themonsteredu/keyring/README.md

# 키링 스튜디오 · 우유팩 감정·날씨 키링

ESP32-C3 SuperMini와 128×64 OLED로 만드는 **우유팩 표정 키링**입니다. **2.2.0**은 도톰한 눈·입으로 여섯 감정을 보여 주고, 날씨는 웃는 아이콘·온도·습도로 표시합니다. 웹에서 표정을 고르거나 블록으로 움직이는 순서를 만들어 실제 키링에 저장할 수 있습니다.

[온라인 키링 스튜디오 열기](https://keyring-swart.vercel.app) · [Arduino IDE용 ZIP 내려받기](https://raw.githubusercontent.com/themonsteredu/keyring/main/downloads/Keyring-Arduino.zip)

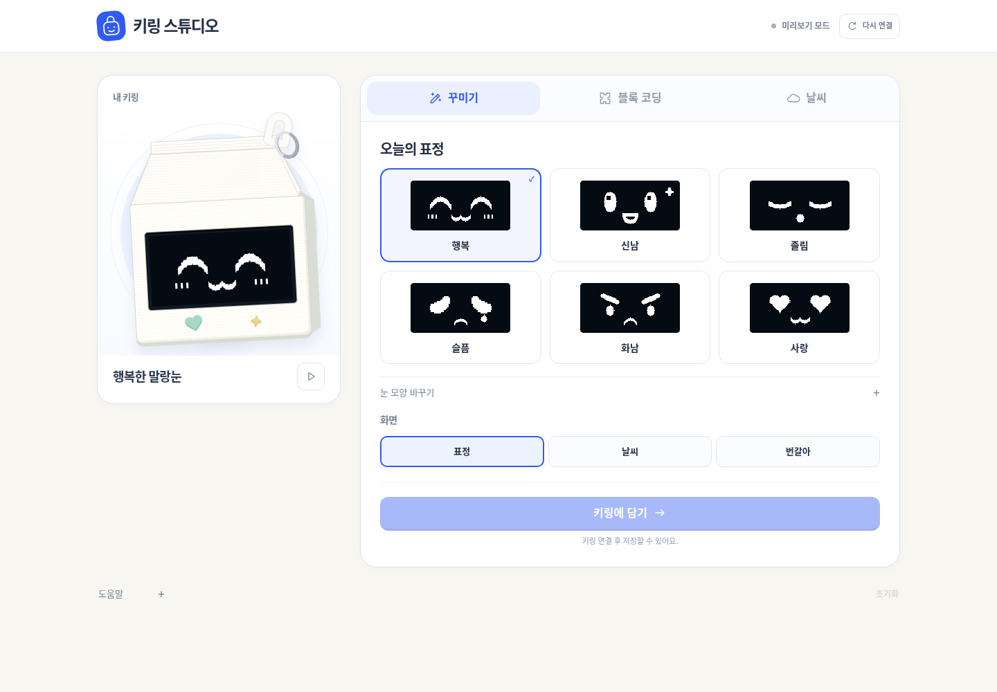
[picture p1: docs/images/studio-desktop.png]
키링 스튜디오 화면


[모바일 화면 보기](docs/images/studio-mobile.png) · [블록코딩 사용법](docs/block-coding.md)

## 우유팩 케이스 3D 출력

[우유팩 STL 묶음 다운로드](https://raw.githubusercontent.com/themonsteredu/keyring/main/downloads/Milk-Carton-Keyring-STL.zip) · [출력·조립 안내](cad/milk-carton/README.md)

본체·뒷뚜껑·OLED 시험판 STL과 편집용 STEP을 제공합니다. 조립 크기는 약 **42 × 75 × 34.4mm**입니다. 일반적인 모듈 치수를 기준으로 한 시제품이므로 OLED 시험판을 먼저 출력하세요. 케이스 고정용 **플라스틱용 2×8mm 나사 4개와 절연 폼테이프**가 별도로 필요합니다.

## 준비물과 고정 배선

현재 필요한 부품은 ESP32-C3 SuperMini, 0.96인치 I2C SSD1306 OLED, 암암 점퍼선 4개, 데이터 전송이 되는 USB-C 케이블입니다. 전원은 USB를 사용합니다. 배터리·충전 회로·추가 버튼은 가정하지 않습니다.

| OLED | ESP32-C3 SuperMini |
| --- | --- |
| GND | G |
| VCC | 3.3V |
| SDA | GPIO4 |
| SCL | GPIO5 |

**SDA는 GPIO4, SCL은 GPIO5로 고정합니다.** 이 배선은 기존 `OLED OK` 테스트에서 동작한 배선입니다. USB 전원을 분리한 상태에서 연결하고, OLED VCC를 5V에 연결하지 않습니다.

## 처음 사용하기

1. [Arduino IDE용 ZIP](downloads/Keyring-Arduino.zip)을 내려받아 `Keyring/Keyring.ino`를 엽니다. 전체 저장소를 받았다면 `firmware/Keyring/Keyring.ino`를 사용합니다. [배선·업로드 안내](docs/hardware-and-upload.md)에 따라 라이브러리를 준비하고 업로드합니다.
2. 시리얼 모니터에서 기기의 Wi-Fi 이름을 확인합니다. 기기별 이름은 `Keyring-XXXXXX`입니다.
3. 스마트폰에서 해당 Wi-Fi에 접속합니다. 기본 수업용 암호는 `keyring123`입니다.
4. 인터넷에 연결되지 않았다는 안내가 나오면 이 Wi-Fi 연결을 유지합니다. 브라우저 주소창에 `http://192.168.4.1`을 입력합니다.
5. **꾸미기** 탭에서 표정을 고르고 **키링에 담기**를 누릅니다. 다른 눈 모양은 **눈 모양 바꾸기**를 펼쳐 고릅니다. 저장 성공 안내와 실제 OLED를 모두 확인합니다.
6. **블록 코딩**에서 순서·기다리기·반복 블록을 연결하고 **실행**을 누릅니다. **키링에 담기** 후 실제 OLED에서도 확인합니다.
7. 날씨는 아래의 **인터넷 없이 날씨 가져오기** 절차를 사용합니다.

Arduino IDE는 **ESP32C3 Dev Module**, ESP32 코어 **3.3.7**, Flash **4MB**, **USB CDC On Boot: Enabled**, **Partition Scheme: Huge APP (3MB No OTA/1MB SPIFFS)**로 설정합니다. 확인된 GPIO4/5 배선은 바꾸지 않습니다.

키링 Wi-Fi는 설정용 AP이며 인터넷 공유기가 아닙니다. 표정 설정과 저장에는 인터넷이 필요 없습니다. 기본 암호는 수업 편의를 위한 공용 암호이므로 개인 정보나 민감한 자료를 입력하지 말고, 사용을 마치면 전원을 분리합니다.

## 표정과 화면

첫 화면에는 미리보기와 여섯 표정, 담기 버튼이 보입니다. 눈 모양 선택은 **눈 모양 바꾸기**, 연결 안내는 하단 **도움말**을 펼쳐 확인합니다.

- 눈 모양: 말랑눈, 초롱눈, 웃음눈, 콩알눈, 네모눈
- 감정: 행복, 신남, 졸림, 슬픔, 화남, 사랑
- 애니메이션: 도톰한 눈의 깜빡임, 작은 입의 변화, 하트·눈물·졸음 표현
- 화면 모드: 표정, 날씨, 번갈아(자동 전환)

OLED에는 동물의 몸이나 얼굴 테두리를 그리지 않습니다. 케이스 자체가 캐릭터의 몸이 되고 화면은 표정을 보여 줍니다. 웹 미리보기도 우유팩 모양이며, 실제 케이스의 제작 치수나 조립 파일을 대신하지 않습니다.

픽셀 렌더러가 만든 128×64 흑백 프레임을 OLED와 웹 미리보기가 함께 사용합니다. 미리보기는 확대되어 보이지만 픽셀 비율은 같습니다. 화면은 일정 간격으로 갱신하고, 변경된 프레임만 전송합니다. OLED를 지우는 빈 화면을 중간에 따로 전송하지 않습니다.

## 실제로 실행하는 블록코딩

블록코딩은 Google Blockly를 사용하는 시각적 편집기입니다. 눈 모양 선택, 감정 선택, 기다리기, 날씨 보여주기, 반복, 날씨 조건 블록을 연결하면 프로그램이 됩니다. 편집기와 한국어 메시지는 웹 자산에 포함되어 키링 AP에서도 외부 CDN 없이 열립니다.

1. **키링 시작할 때 → 말랑눈 → 행복 → 1초 기다리기 → 사랑 → 1초 기다리기** 순서로 연결합니다.
2. **실행**으로 순서대로 표정이 바뀌는지 확인합니다. **반복**을 켜면 처음부터 계속 실행합니다.
3. 키링 AP에 연결된 화면에서 **키링에 담기**을 누릅니다. 실행이 켜진 프로그램은 전원을 다시 연결하면 기기에서 처음부터 실행합니다.
4. 직접 눈 모양과 표정을 고르고 적용하면 실행 중인 프로그램이 멈춥니다. 프로그램을 다시 실행하려면 블록 코딩 화면에서 **키링에 담기**을 누릅니다.

온라인 Vercel 화면은 실제 기기와 직접 연결되지 않습니다. 온라인에서 만든 프로그램을 **파일 저장 → 키링 Wi-Fi로 전환 → 불러오기 → 키링에 담기** 순서로 옮깁니다. 브라우저 미리 실행과 기기에 저장한 실행은 구분합니다. 단계별 설명과 예제는 [블록코딩 안내](docs/block-coding.md)에 있습니다.

**도톰한 표정과 온도·습도 화면을 실제 OLED에 표시하려면 2.2.0 펌웨어를 다시 업로드해야 합니다.** 위 ZIP을 받거나 `firmware/Keyring/Keyring.ino`를 다시 빌드·업로드합니다. Vercel 화면만 새로 열어도 보드의 그림은 바뀌지 않습니다. 프로그램 API가 없는 예전 펌웨어 역시 업로드가 필요합니다. GPIO4/5 배선은 유지합니다.

## 인터넷 없이 날씨 가져오기

키링 자체가 인터넷에 접속하지 않아도 다음 순서로 실제 예보를 옮길 수 있습니다.

1. 인터넷이 되는 상태에서 이 프로젝트의 웹 화면을 엽니다. [온라인 키링 스튜디오](https://keyring-swart.vercel.app) 또는 교사가 준비한 PC 개발 서버를 사용할 수 있습니다.
2. **날씨** 탭에서 지역을 고르고 **날씨 받기**를 누릅니다. **파일 · 연습 → 파일 저장**에서 JSON을 내려받습니다.
3. 스마트폰을 키링 Wi-Fi로 바꿔 연결합니다.
4. `http://192.168.4.1`의 **날씨 → 파일 · 연습 → 불러오기**에서 JSON을 고릅니다. 연결된 키링에 저장됩니다.
5. 저장 성공을 확인합니다. **받은 시각 · 출처**에서 파일 정보를 볼 수 있습니다. 꾸미기의 화면을 **날씨** 또는 **번갈아**로 고르고 **키링에 담기**를 누릅니다.

휴대전화가 Wi-Fi와 이동통신을 동시에 사용할 수 있으면 기기 화면에서 직접 날씨를 받을 수도 있습니다. 휴대전화별 동작이 다르므로 수업에서는 파일 가져오기 방식을 준비하세요. 자세한 설명은 [날씨와 시간 처리](docs/weather.md)에 있습니다.

날씨 기본 화면에는 **큰 아이콘·반올림한 온도·상대습도**가 나타납니다. 습도는 선택한 지역의 Open-Meteo 예보 값이며 별도 실내 센서를 사용하지 않습니다. 예전 파일에 습도가 없으면 `--%`로 표시합니다. 웹의 **24시간 예보**, **받은 시각 · 출처**는 펼쳐서 확인합니다. OLED에서도 한 번에 한 시간의 예보를 보여 줍니다.

연습용·오래된 예보·시각 미확인은 작은 한글 표시로 구분합니다. **전원을 완전히 껐다 켜면 시계는 미확인 상태가 됩니다.** 스마트폰 설정 화면을 다시 열면 시간을 맞춥니다. 받은 지 3시간이 지났거나 예보 범위를 벗어난 파일은 새로 받아 주세요.

Open-Meteo의 무료 API는 비상업적 사용 조건이 적용됩니다. 유료 수업·판매 제품 등 상업적 사용 여부는 배포 전에 [공식 이용약관](https://open-meteo.com/en/terms)을 확인하고 적절한 이용 방식을 선택해야 합니다. 기상 데이터 출처는 Open-Meteo, 라이선스는 [CC BY 4.0](https://open-meteo.com/en/licence)입니다. 안전 판단이나 재난 경보용으로 사용하지 않습니다.

## 개발·빌드·테스트

클라우드 설치 스크립트는 Linux x86_64용입니다. 기본 도구로 Python 3.12 이상, Node.js 22 이상, C++ 컴파일러가 필요합니다. `tools/setup.sh`는 Arduino CLI **1.3.1**, ESP32 Arduino Core **3.3.7**, 고정 버전 라이브러리를 저장소 상위의 `.tooling`(이 환경에서는 `/workspace/.tooling`)에 준비하고 공식 배포 체크섬을 검증합니다. 웹 테스트 의존성은 `npm ci`로 설치합니다. Windows·macOS에서는 [Arduino IDE 안내](docs/hardware-and-upload.md)를 사용합니다.

```sh
cd /workspace/keyring
bash tools/setup.sh
bash tools/test.sh
bash tools/build.sh
npm run test:e2e
```

웹 개발 서버는 다음과 같이 실행합니다.

```sh
python3 tools/dev_server.py --port 8000
```

기본 개발 서버는 기기 API가 없는 독립 웹 화면으로 실행됩니다. 개발·브라우저 테스트용 모의 기기는 `--mock` 옵션으로 켜며, 모의 응답은 실물 ESP32 검증을 대신하지 않습니다. 스마트폰에서 PC 개발 서버에 접속하려면 PC와 스마트폰이 같은 네트워크에 있어야 하며, PC의 네트워크 주소를 사용해야 합니다. 기본 서버는 PC 내부 접속용이므로 스마트폰에도 열려면 `--host 0.0.0.0` 옵션을 추가합니다. 키링 AP 주소는 실제 펌웨어를 업로드한 기기에 접속했을 때만 사용할 수 있습니다.

웹 파일을 수정한 후에는 펌웨어용 웹 자산을 다시 생성하고 빌드해야 합니다. 웹 자산은 펌웨어에 포함되므로 별도의 SPIFFS/LittleFS 파일 업로드는 필요하지 않습니다. 세부 명령과 테스트 범위는 [개발 구조·API](docs/development.md)를 참고하세요.

## 폴더 구성

```text
firmware/Keyring/   Arduino 스케치, 픽셀 렌더러, 저장·시간 규칙, 내장 웹 자산
web/               꾸미기·Blockly·날씨 UI, 공통 픽셀 프레임, 로컬 편집기 자산
tools/             설치·빌드·자산 생성·개발 서버
tests/             C++ 및 JavaScript 테스트
docs/              배선, 업로드, 학생·교사 안내, 날씨와 API 설명
```

## 검증 범위

이 저장소의 자동 테스트는 픽셀 데이터, 설정·시간·날씨 규칙, 프로그램 검증·실행과 웹 동작을 대상으로 하며, ESP32-C3 타깃 빌드는 업로드 가능한 펌웨어의 컴파일을 검증합니다. **클라우드에서 실물 보드에 업로드하거나 물리 OLED를 관찰한 것은 아닙니다.** 사용자가 앞서 확인한 `OLED OK`는 기존 하드웨어·배선 테스트 결과이며 이번 통합 펌웨어의 실물 검증 결과와 구분합니다.

수업 전에 [교사용 확인표](docs/teacher-guide.md)의 업로드, OLED 표시, 설정 저장 후 전원 재연결, 인터넷 없는 날씨 표시, 시계 미확인 표시, 초기화를 실제 기기로 확인하세요. 이번 작업의 실행 결과와 남은 제한은 작업 완료 보고에서 확인할 수 있습니다.

클라우드의 [빌드·테스트 실행 기록](docs/verification.md)에서 검증 대상 버전과 실제 실행한 결과를 확인합니다. 버전별 통과 수와 빌드 크기는 해당 실행 기록을 따릅니다. 실물·외부 API 항목은 별도로 확인해야 합니다.

## 수업 안내

- [학생용 만들기·사용 안내](docs/student-guide.md)
- [학생·교사용 블록코딩 안내](docs/block-coding.md)
- [교사용 2차시 수업·제작 안내](docs/teacher-guide.md)
- [배선·Arduino IDE 업로드·문제 해결](docs/hardware-and-upload.md)
- [날씨 출처·오프라인 사용·시간 정확도](docs/weather.md)
- [개발 구조·API·검증](docs/development.md)
- [Vercel 웹앱 배포](docs/vercel.md)
