themonsteredu/keyring/docs/images/studio-blocks-mobile.png

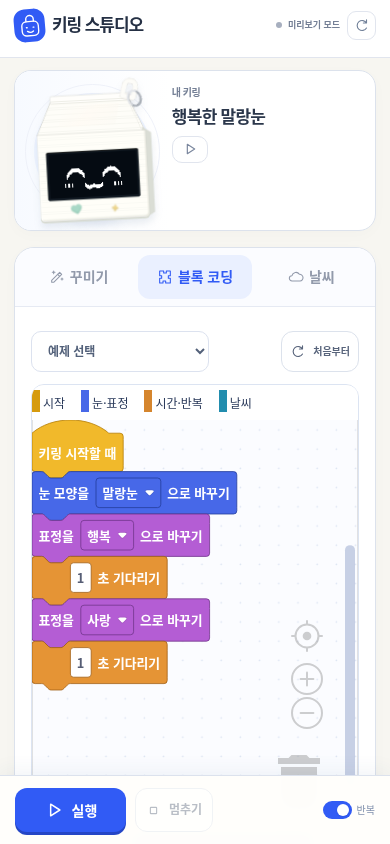
docs/images/studio-blocks-mobile.png
