themonsteredu/keyring/docs/images/studio-mobile.png

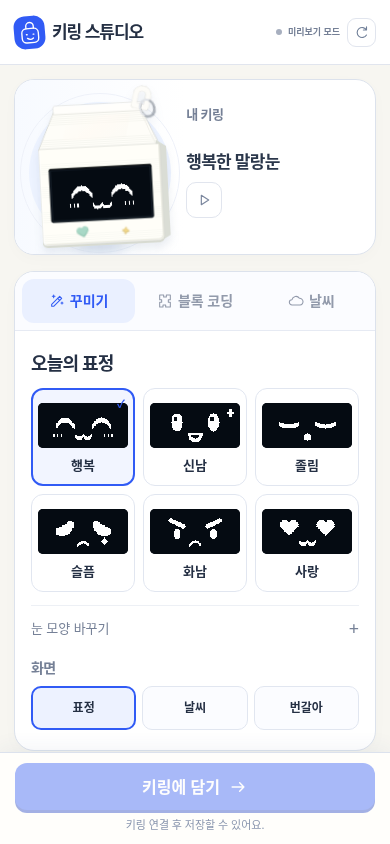
docs/images/studio-mobile.png
