themonsteredu/keyring/docs/images/studio-weather.png

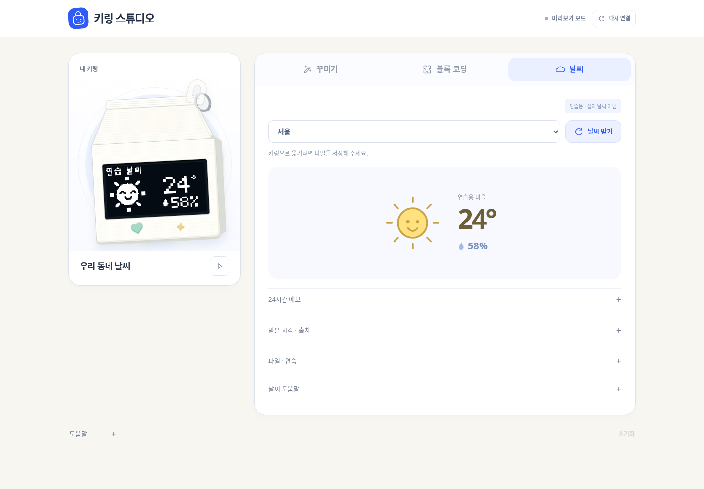
docs/images/studio-weather.png
