themonsteredu/keyring/downloads/milk-carton/milk_case_assembly.step

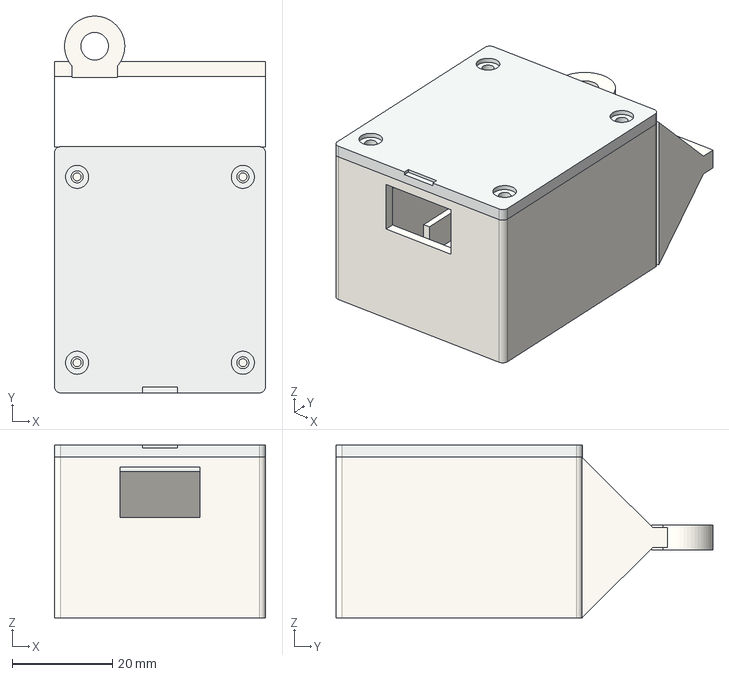
[picture p7: CAD file, 2026-10-24]
downloads/milk-carton/milk_case_assembly.step
42.0 x 75.0 x 34.4 mm
lid
