themonsteredu/keyring/downloads/milk-carton/oled_fit_check.stl

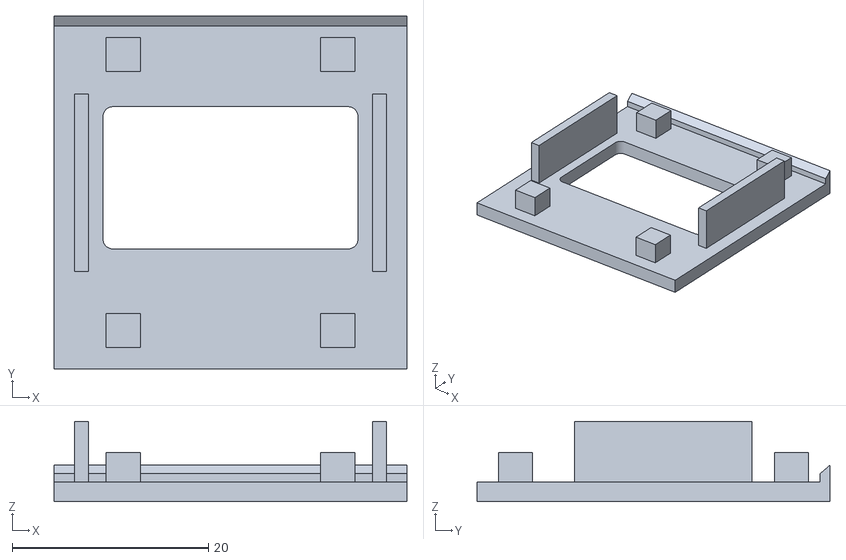
[picture p8: CAD file, 2026-10-24]
downloads/milk-carton/oled_fit_check.stl
36.0 x 36.0 x 8.20
