themonsteredu/keyring/downloads/milk-carton/milk_case_body.stl

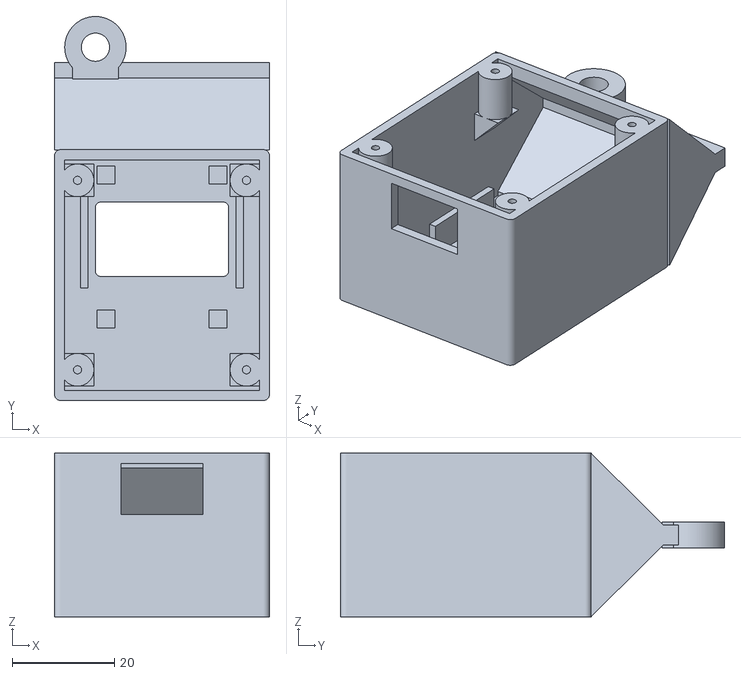
[picture p9: CAD file, 2026-10-24]
downloads/milk-carton/milk_case_body.stl
42.0 x 75.0 x 32.0
