themonsteredu/keyring/downloads/milk-carton/milk_case_lid.stl

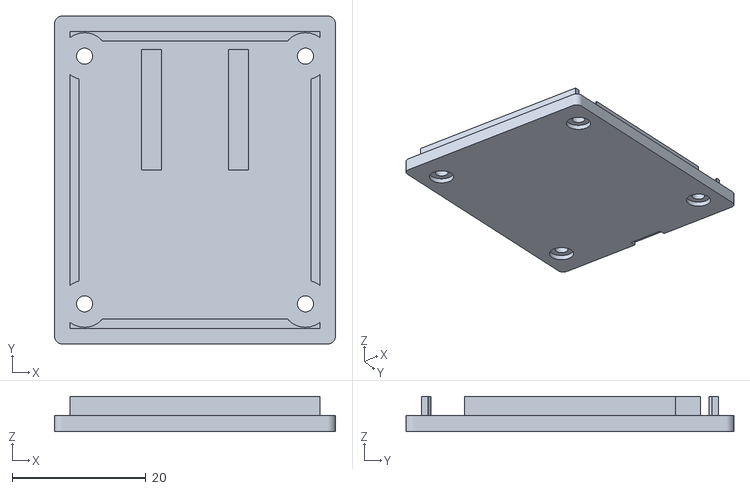
[picture p10: CAD file, 2026-10-24]
downloads/milk-carton/milk_case_lid.stl
42.0 x 49.0 x 5.30
