themonsteredu/keyring/(commit log)

2026-10-23 Build ESP32-C3 emotion and weather keyring system
2026-10-23 Add downloadable Arduino sketch package
2026-10-23 Build a visual block coding studio with on-device programs
2026-10-24 Add printable milk carton keyring case with lid and OLED fit coupon
2026-10-24 Match milk carton case to supplied OLED dimensions and top header
